AaronLieberman/VolumeControl/README.md

# VolumeControl

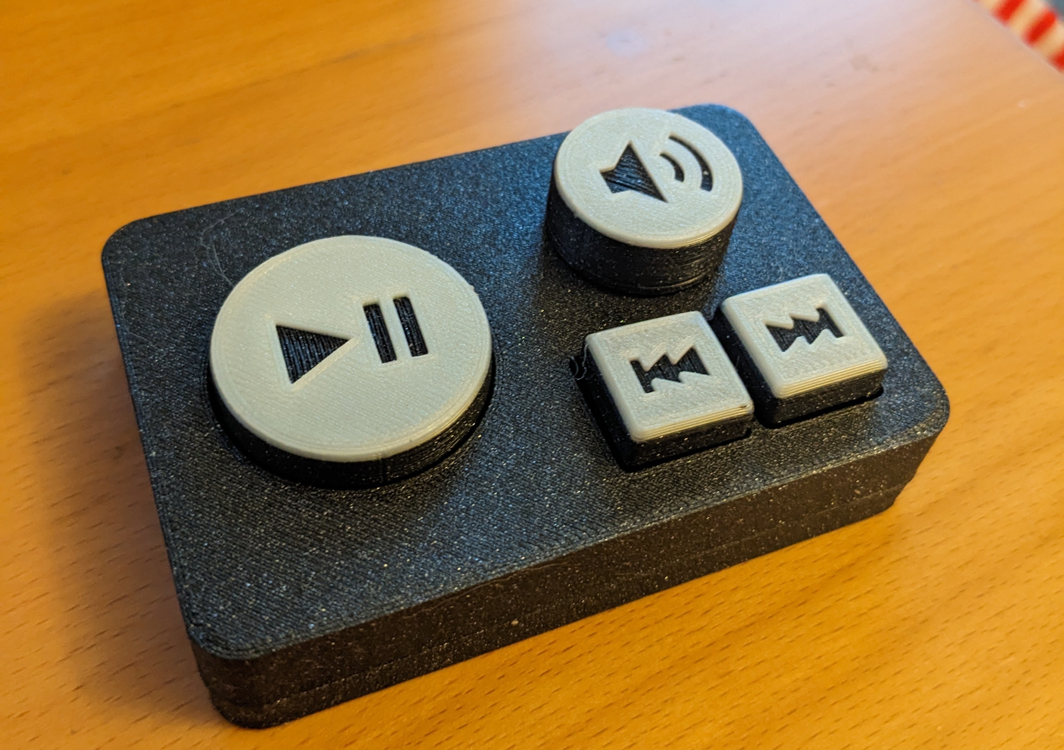
[picture p1: VolumeControl.jpg]
Volume Control image

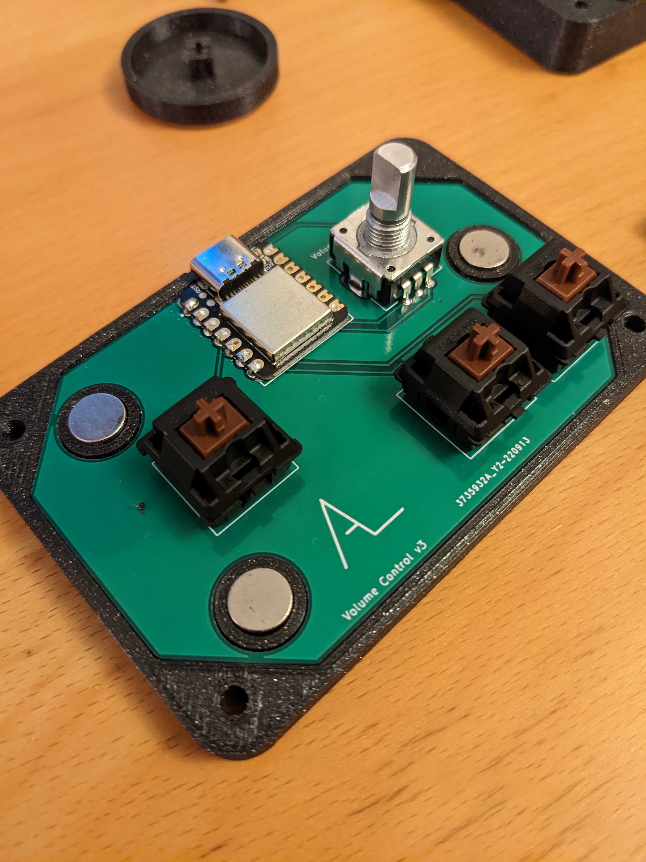
[picture p2: VolumeControlTopWithComponents.jpg]
Volume Control image


This repo contains the files to make the Volume Control v3:
- KiCad
- CAD (Fusion 360 + STLs)
- Arduino code
