AaronLieberman/VolumeControl/CAD/Next.3mf

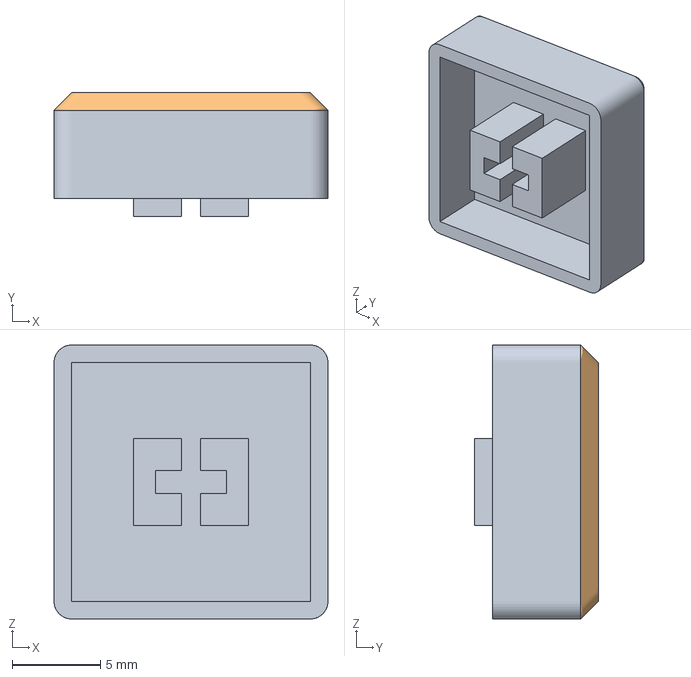
[picture p3: CAD file, 2024-09-12]
CAD/Next.3mf
15.5 x 7.00 x 15.5 mm
Prev
PrevTop
