AaronLieberman/VolumeControl/CAD/VolumeKnob.3mf

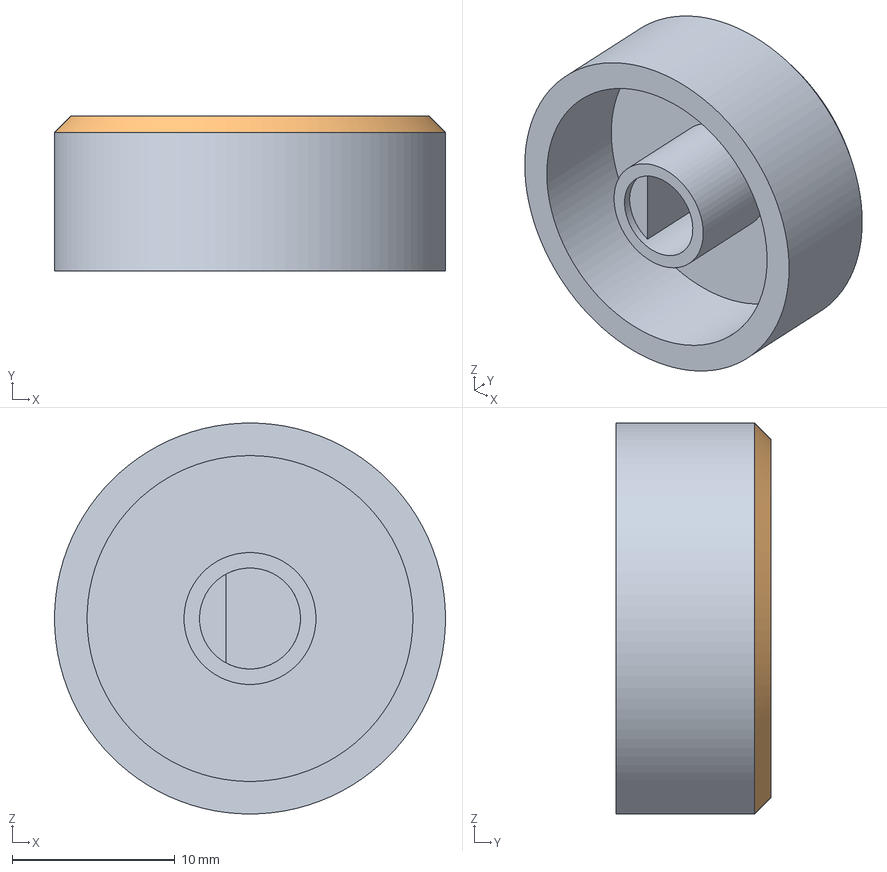
[picture p4: CAD file, 2024-09-12]
CAD/VolumeKnob.3mf
24.0 x 9.50 x 24.0 mm
VolumeKnob
VolumeKnobTop
