AaronLieberman/VolumeControl/CAD/PlayPauseCap.3mf

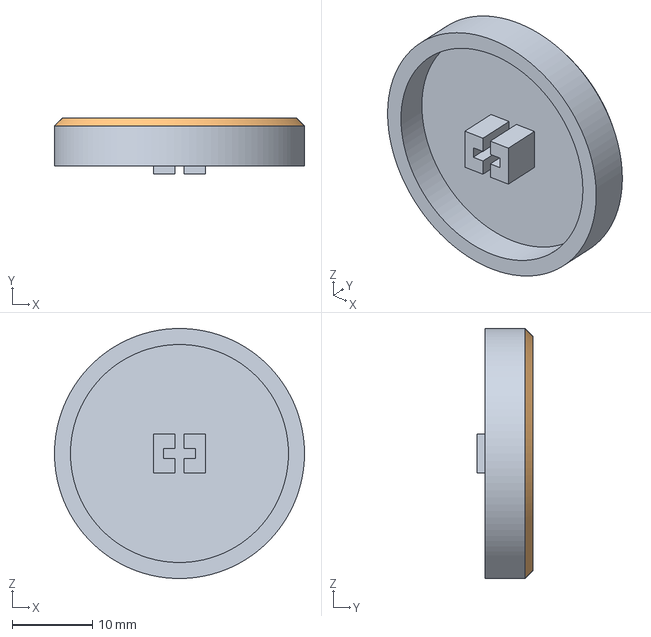
[picture p5: CAD file, 2024-09-12]
CAD/PlayPauseCap.3mf
31.2 x 7.00 x 31.2 mm
PlayPauseCap
PlayPauseCapTop
