AaronLieberman/VolumeControl/CAD/Top.3mf

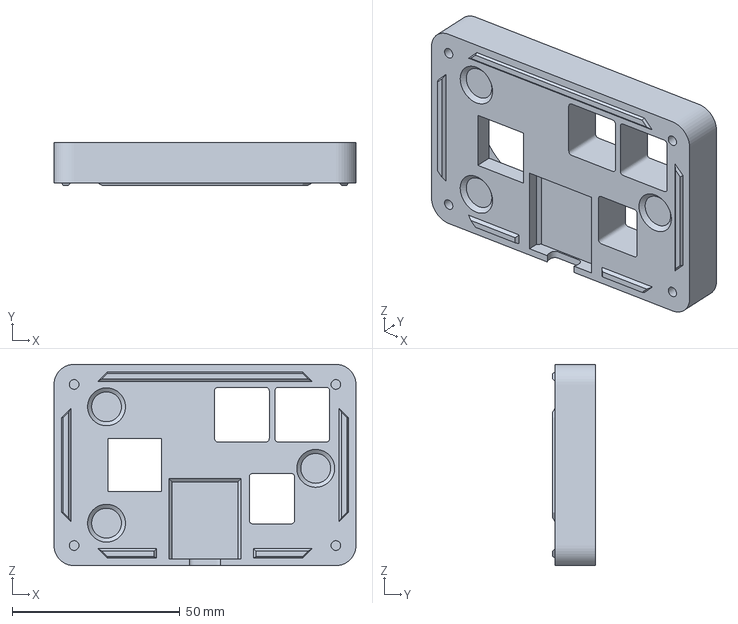
[picture p6: CAD file, 2024-08-10]
CAD/Top.3mf
90.0 x 12.8 x 60.0 mm
