AaronLieberman/VolumeControl/CAD/Cover.3mf

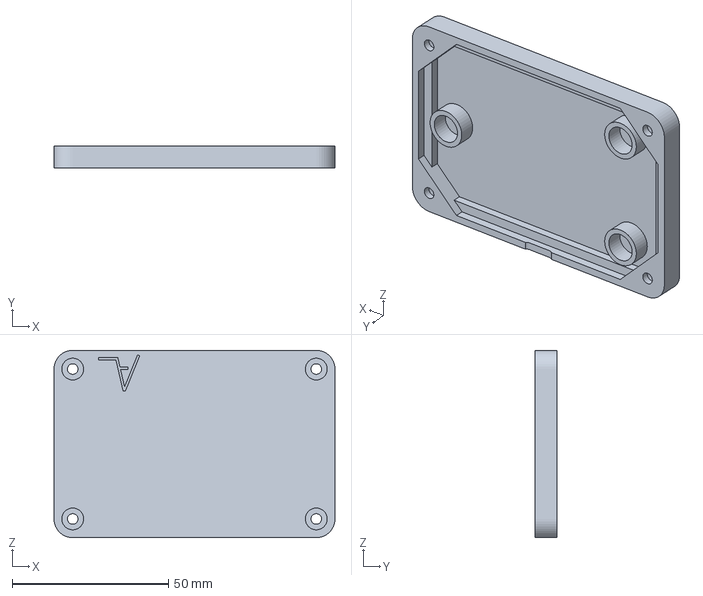
[picture p7: CAD file, 2024-08-10]
CAD/Cover.3mf
90.0 x 7.00 x 60.0 mm
