AaronLieberman/VolumeControl/(list of files, cad)

Other CAD files:
CAD/Prev.3mf
CAD/Volume v3.f3z
