AaronLieberman/VolumeControl/KiCad/Volume Control.kicad_sch

## KiCad design KiCad/Volume Control.kicad_sch (2024-08-10)

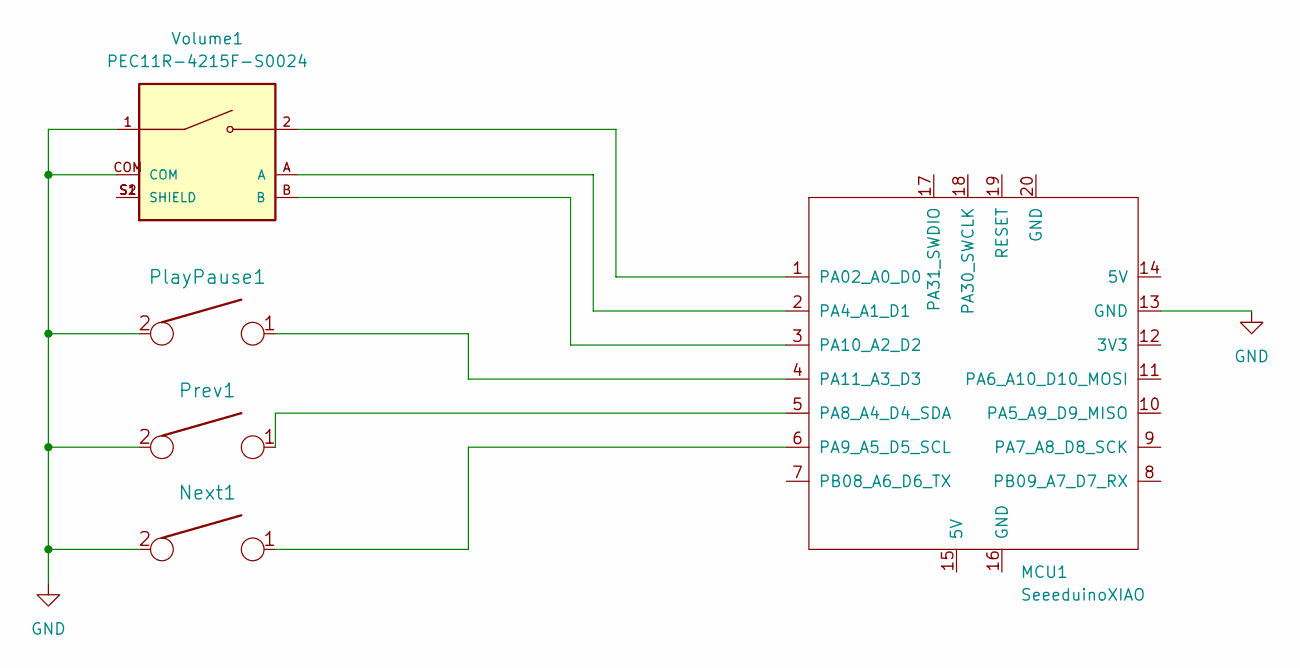
[picture p8: schematic Volume Control.kicad_sch]

Parts:
MCU1: SeeeduinoXIAO; Seeeduino XIAO-MOUDLE14P-2.54-21X17.8MM
Next1: KEYSW; SW_Cherry_MX_1.00u_PCB
PlayPause1: KEYSW; SW_Cherry_MX_1.00u_PCB
Prev1: KEYSW; SW_Cherry_MX_1.00u_PCB
Volume1: PEC11R-4215F-S0024; XDCR_PEC11R-4215F-S0024; PARTREV Rev. 09/19

Connections:
GND: MCU1.13 (GND), Next1.2, PlayPause1.2, Prev1.2, Volume1.1, Volume1.COM
unnamed: MCU1.1 (PA02_A0_D0), Volume1.2
unnamed: MCU1.2 (PA4_A1_D1), Volume1.A
unnamed: MCU1.3 (PA10_A2_D2), Volume1.B
unnamed: MCU1.4 (PA11_A3_D3), PlayPause1.1
unnamed: MCU1.5 (PA8_A4_D4_SDA), Prev1.1
unnamed: MCU1.6 (PA9_A5_D5_SCL), Next1.1
unnamed: Volume1.S1 (SHIELD), Volume1.S2 (SHIELD)
