AaronLieberman/VolumeControl/(commit log)

2024-08-10 Initial checkin of VolumeControl v2 KiCad files
    [Volume Control.kicad_sch, board.dxf]
2024-08-10 Update to newest KiCad file versions
    [Volume Control.kicad_sch]
2024-08-10 Move files to KiCad subdir
    [Volume Control.kicad_sch, board.dxf]
2024-08-10 CAD files export from Fusion 360 (v35)
    [Cover.3mf, Next.3mf, PlayPauseCap.3mf, Prev.3mf, Top.3mf, Volume v3.f3z, VolumeKnob.3mf]
2024-08-10 Copy from ArduinoTinkering project
2024-09-12 move stuff around due to arduino reqs
2024-09-12 add some updated stl files
    [Next.3mf, PlayPauseCap.3mf, Prev.3mf, VolumeKnob.3mf]
